bytex64/game-middle-aged-man/logo.dxf

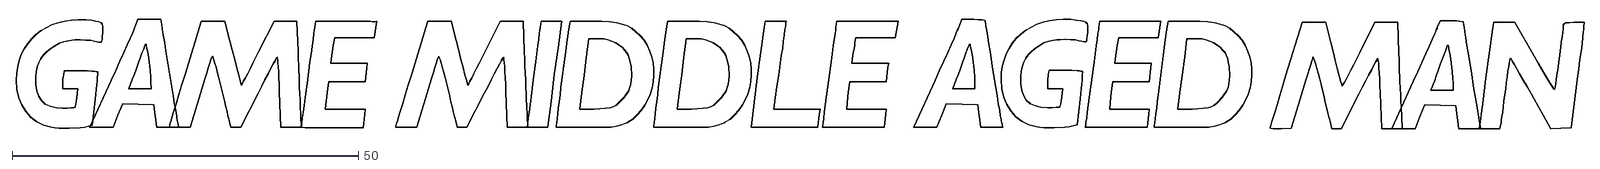
[picture p1: CAD file, 2020-11-22]
logo.dxf
226.6 x 16.3
