bytex64/game-middle-aged-man/gamething.kicad_pcb

## KiCad design gamething.kicad_pcb (2020-11-22)

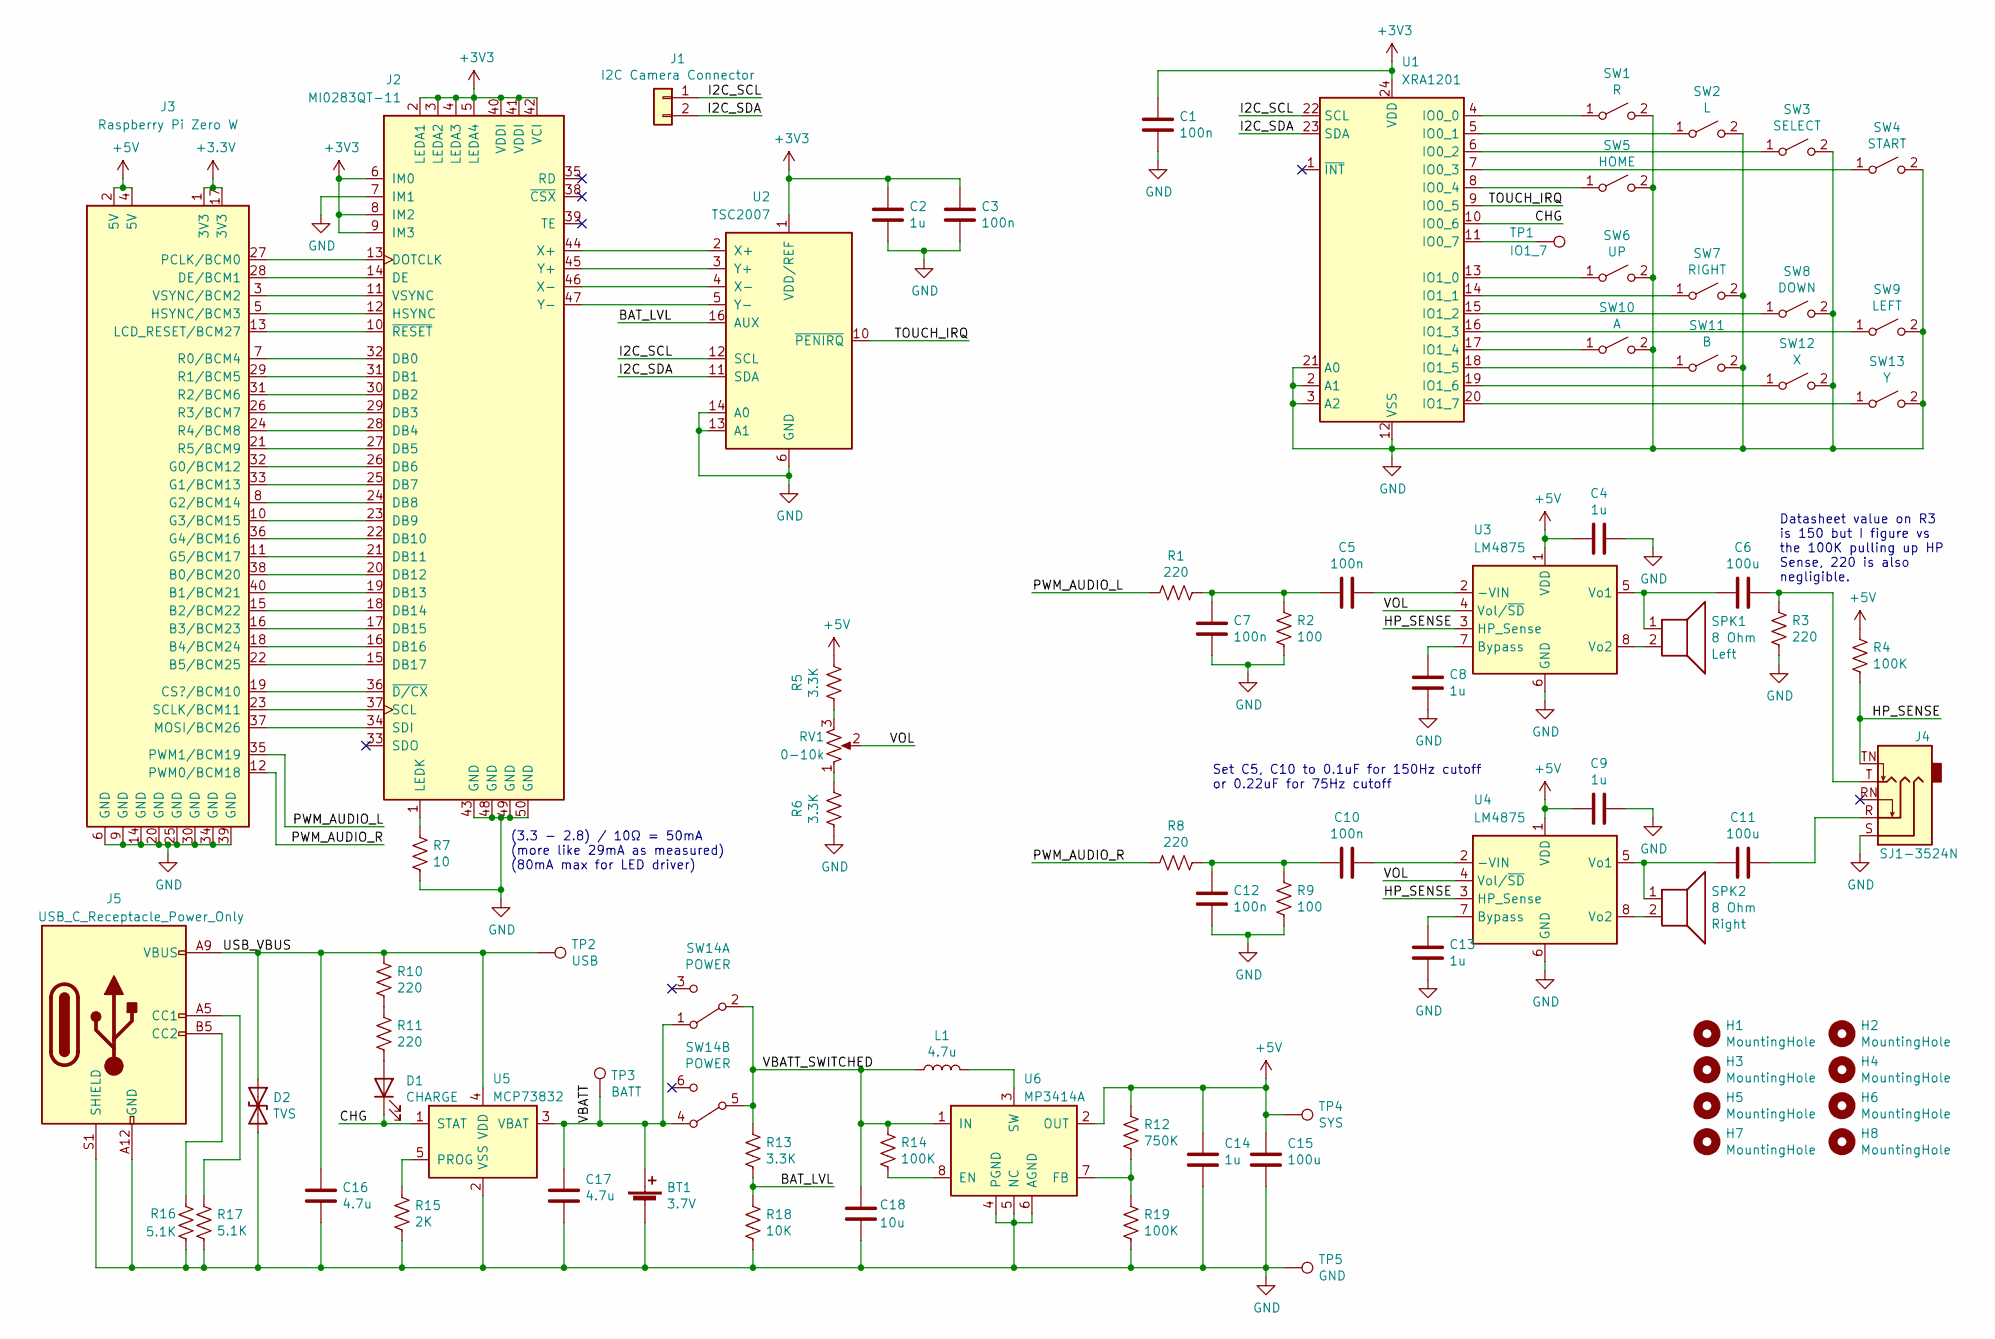
[picture p2: schematic gamething.sch, Game Middle Aged Man]

Parts:
BT1: 3.7V; JST_PH_S2B-PH-K_1x02_P2.00mm_Horizontal; MPN Harwin M22-2210246 or TE 440055-2
C1, C3, C5, C7, C10, C12: 100n; C_0805_2012Metric_Pad1.15x1.40mm_HandSolder; MPN CL21B104KACNNNC
C2, C4, C8, C9, C13, C14: 1u; C_0805_2012Metric_Pad1.15x1.40mm_HandSolder; MPN C0805C105K4RACTU
C6, C11, C15: 100u; C_1206_3216Metric_Pad1.42x1.75mm_HandSolder; MPN JMK316ABJ107ML-T
C16, C17: 4.7u; C_0805_2012Metric_Pad1.15x1.40mm_HandSolder; MPN CL21A475KPFNNNE
C18: 10u; C_0805_2012Metric_Pad1.15x1.40mm_HandSolder; MPN C0805C106K8PACTU
D1: CHARGE; LED_D3.0mm; MPN LTL-4221N
D2: TVS; D_SOD-323_HandSoldering; MPN DF2B7AFU,H3F
H1, H2, H3, H4, H5, H6, H7, H8: MountingHole; MountingHole_2.7mm_M2.5
J1: I2C Camera Connector; PinHeader_1x02_P2.54mm_Vertical
J2: MI0283QT-11; MI0283QT-11_tucked_connector; MPN 62684-50210E9ALF
J3: Raspberry Pi Zero W; Raspberry_Pi_Zero_Socketed_THT_FaceDown_MountingHoles
J4: SJ1-3524N; SJ1-3525N; MPN SJ1-3524N
J5: USB_C_Receptacle_Power_Only; UJC-HP-3-SMT; MPN UJC-HP-3-SMT
L1: 4.7u; L_6x6_H4.5_Handsoldering; MPN TYS60454R7M-10
R1, R3, R8, R10, R11: 220; R_0805_2012Metric_Pad1.15x1.40mm_HandSolder; MPN RK73B2ATTD221J
R2, R9: 100; R_0805_2012Metric_Pad1.15x1.40mm_HandSolder; MPN RK73H2ATTE1000F
R4, R14, R19: 100K; R_0805_2012Metric_Pad1.15x1.40mm_HandSolder; MPN CR0805AFX-1003ELF
R5, R6, R13: 3.3K; R_0805_2012Metric_Pad1.15x1.40mm_HandSolder; MPN CR0805-FX-3301ELF
R7: 10; R_Axial_DIN0207_L6.3mm_D2.5mm_P7.62mm_Horizontal
R12: 750K; R_0805_2012Metric_Pad1.15x1.40mm_HandSolder
R15: 2K; R_0805_2012Metric_Pad1.15x1.40mm_HandSolder; MPN CR0805-FX-2001ELF
R16, R17: 5.1K; R_0805_2012Metric_Pad1.15x1.40mm_HandSolder; MPN RK73B2ATTD512J
R18: 10K; R_0805_2012Metric_Pad1.15x1.40mm_HandSolder; MPN RK73H2ATTD1002F
RV1: 0-10k; RK10J11E; MPN RK10J11E0034
SPK1, SPK2: 8 Ohm; PinHeader_1x02_P2.54mm_Vertical; MPN SM300408-4
SW1: R; B3F-3100; MPN B3F-3100
SW2: L; B3F-3100; MPN B3F-3100
SW3: SELECT; B3F-1000_2terminal; MPN B3F-1000
SW4: START; B3F-1000_2terminal; MPN B3F-1000
SW5: HOME; B3F-1000_2terminal; MPN B3F-1000
SW6: UP; B3F-1000_2terminal; MPN B3F-1000
SW7: RIGHT; B3F-1000_2terminal; MPN B3F-1000
SW8: DOWN; B3F-1000_2terminal; MPN B3F-1000
SW9: LEFT; B3F-1000_2terminal; MPN B3F-1000
SW10: A; B3F-1000_2terminal; MPN B3F-1000
SW11: B; B3F-1000_2terminal; MPN B3F-1000
SW12: X; B3F-1000_2terminal; MPN B3F-1000
SW13: Y; B3F-1000_2terminal; MPN B3F-1000
SW14: POWER; JS202011AQN; MPN JS202011AQN
TP1: IO1_7; TestPoint_THTPad_D1.5mm_Drill0.9mm
TP2: USB; TestPoint_THTPad_D1.5mm_Drill0.9mm
TP3: BATT; TestPoint_THTPad_D1.5mm_Drill0.9mm
TP4: SYS; TestPoint_THTPad_D1.5mm_Drill0.9mm
TP5: GND; TestPoint_THTPad_D1.5mm_Drill0.9mm
U1: XRA1201; TSSOP-24_4.4x7.8mm_P0.65mm; MPN XRA1201PIG24TR-F
U2: TSC2007; TSSOP-16_4.4x5mm_P0.65mm; MPN TSC2007IPWR
U3, U4: LM4875; SOIC-8_3.9x4.9mm_P1.27mm; MPN LM4875MX/NOPB
U5: MCP73832; SOT-23-5; MPN MCP73832T-2ACI/OT
U6: MP3414A; TSOT-23-8; MPN MP3414AGJ-Z

Connections:
+5V: C4.2, C9.2, C14.1, C15.1, J3.2 (5V), J3.4 (5V), R4.2, R5.1, R12.1, TP4.1, U3.1 (VDD), U4.1 (VDD), U6.2 (OUT)
/BAT_LVL: R13.2, R18.1, U2.16 (AUX)
/CHG: D1.1 (K), U1.10 (IO0_6), U5.1 (STAT)
/HP_SENSE: J4.TN, R4.1, U3.3 (HP_Sense), U4.3 (HP_Sense)
/I2C_SCL: J1.1, U1.22 (SCL), U2.12 (SCL)
/I2C_SDA: J1.2, U1.23 (SDA), U2.11 (SDA)
/PWM_AUDIO_L: J3.35 (PWM1/BCM19), R1.2
/PWM_AUDIO_R: J3.12 (PWM0/BCM18), R8.2
/TOUCH_IRQ: U1.9 (IO0_5), U2.10 (~PENIRQ)
/USB_VBUS: C16.1, D2.1 (A1), J5.A9 (VBUS), J5.B9 (VBUS), R10.1, TP2.1, U5.4 (VDD)
/VBATT: BT1.1 (+), C17.1, SW14.1 (A), SW14.4 (A), TP3.1, U5.3 (VBAT)
/VBATT_SWITCHED: C18.1, L1.1, R13.1, R14.1, SW14.2 (B), SW14.5 (B), U6.1 (IN)
/VOL: RV1.2, U3.4 (Vol/~SD), U4.4 (Vol/~SD)
GND: BT1.2 (-), C1.2, C2.2, C3.2, C4.1, C7.2, C8.2, C9.1, C12.2, C13.2, C14.2, C15.2, C16.2, C17.2, C18.2, D2.2 (A2), J2.7 (IM1), J2.43 (GND), J2.48 (GND), J2.49 (GND), J2.50 (GND), J3.6 (GND), J3.9 (GND), J3.14 (GND), J3.20 (GND), J3.25 (GND), J3.30 (GND), J3.34 (GND), J3.39 (GND), J4.S, J5.A12 (GND), J5.B12 (GND), J5.S1 (SHIELD), R2.1, R3.1, R6.2, R7.2, R9.1, R15.2, R16.2, R17.2, R18.2, R19.2, SW1.2 (B), SW2.2 (B), SW3.2 (B), SW4.2 (B), SW5.2 (B), SW6.2 (B), SW7.2 (B), SW8.2 (B), SW9.2 (B), SW10.2 (B), SW11.2 (B), SW12.2 (B), SW13.2 (B), TP5.1, U1.2 (A1), U1.3 (A2), U1.12 (VSS), U1.21 (A0), U2.6 (GND), U2.13 (A1), U2.14 (A0), U3.6 (GND), U4.6 (GND), U5.2 (VSS), U6.4 (PGND), U6.5 (NC), U6.6 (AGND)
unnamed: C5.1, U3.2 (-VIN)
unnamed: C5.2, C7.1, R1.1, R2.2
unnamed: C6.1, J4.T, R3.2
unnamed: C6.2, SPK1.1, U3.5 (Vo1)
unnamed: C8.1, U3.7 (Bypass)
unnamed: C10.1, U4.2 (-VIN)
unnamed: C10.2, C12.1, R8.1, R9.2
unnamed: C11.1, J4.R
unnamed: C11.2, SPK2.1, U4.5 (Vo1)
unnamed: C13.1, U4.7 (Bypass)
unnamed: D1.2 (A), R11.2
unnamed: J2.1 (LEDK), R7.1
unnamed: J2.10 (~RESET), J3.13 (LCD_RESET/BCM27)
unnamed: J2.11 (VSYNC), J3.3 (VSYNC/BCM2)
unnamed: J2.12 (HSYNC), J3.5 (HSYNC/BCM3)
unnamed: J2.13 (DOTCLK), J3.27 (PCLK/BCM0)
unnamed: J2.14 (DE), J3.28 (DE/BCM1)
unnamed: J2.15 (DB17), J3.22 (B5/BCM25)
unnamed: J2.16 (DB16), J3.18 (B4/BCM24)
unnamed: J2.17 (DB15), J3.16 (B3/BCM23)
unnamed: J2.18 (DB14), J3.15 (B2/BCM22)
unnamed: J2.19 (DB13), J3.40 (B1/BCM21)
unnamed: J2.20 (DB12), J3.38 (B0/BCM20)
unnamed: J2.21 (DB11), J3.11 (G5/BCM17)
unnamed: J2.22 (DB10), J3.36 (G4/BCM16)
unnamed: J2.23 (DB9), J3.10 (G3/BCM15)
unnamed: J2.24 (DB8), J3.8 (G2/BCM14)
unnamed: J2.25 (DB7), J3.33 (G1/BCM13)
unnamed: J2.26 (DB6), J3.32 (G0/BCM12)
unnamed: J2.27 (DB5), J3.21 (R5/BCM9)
unnamed: J2.28 (DB4), J3.24 (R4/BCM8)
unnamed: J2.29 (DB3), J3.26 (R3/BCM7)
unnamed: J2.30 (DB2), J3.31 (R2/BCM6)
unnamed: J2.31 (DB1), J3.29 (R1/BCM5)
unnamed: J2.32 (DB0), J3.7 (R0/BCM4)
unnamed: J2.34 (SDI), J3.37 (MOSI/BCM26)
unnamed: J2.36 (~D/CX), J3.19 (CS?/BCM10)
unnamed: J2.37 (SCL), J3.23 (SCLK/BCM11)
unnamed: J2.44 (X+), U2.2 (X+)
unnamed: J2.45 (Y+), U2.3 (Y+)
unnamed: J2.46 (X-), U2.4 (X-)
unnamed: J2.47 (Y-), U2.5 (Y-)
unnamed: J5.A5 (CC1), R17.1
unnamed: J5.B5 (CC2), R16.1
unnamed: L1.2, U6.3 (SW)
unnamed: R5.2, RV1.3
unnamed: R6.1, RV1.1
unnamed: R10.2, R11.1
unnamed: R12.2, R19.1, U6.7 (FB)
unnamed: R14.2, U6.8 (EN)
unnamed: R15.1, U5.5 (PROG)
unnamed: SPK1.2, U3.8 (Vo2)
unnamed: SPK2.2, U4.8 (Vo2)
unnamed: SW1.1 (A), U1.4 (IO0_0)
unnamed: SW2.1 (A), U1.5 (IO0_1)
unnamed: SW3.1 (A), U1.6 (IO0_2)
unnamed: SW4.1 (A), U1.7 (IO0_3)
unnamed: SW5.1 (A), U1.8 (IO0_4)
unnamed: SW6.1 (A), U1.13 (IO1_0)
unnamed: SW7.1 (A), U1.14 (IO1_1)
unnamed: SW8.1 (A), U1.15 (IO1_2)
unnamed: SW9.1 (A), U1.16 (IO1_3)
unnamed: SW10.1 (A), U1.17 (IO1_4)
unnamed: SW11.1 (A), U1.18 (IO1_5)
unnamed: SW12.1 (A), U1.19 (IO1_6)
unnamed: SW13.1 (A), U1.20 (IO1_7)
unnamed: TP1.1, U1.11 (IO0_7)

Notes on the sheet:
(3.3 - 2.8) / 10Ω = 50mA (more like 29mA as measured) (80mA max for LED driver)
Set C5, C10 to 0.1uF for 150Hz cutoff or 0.22uF for 75Hz cutoff
Datasheet value on R3 is 150 but I figure vs the 100K pulling up HP Sense, 220 is also negligible.

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
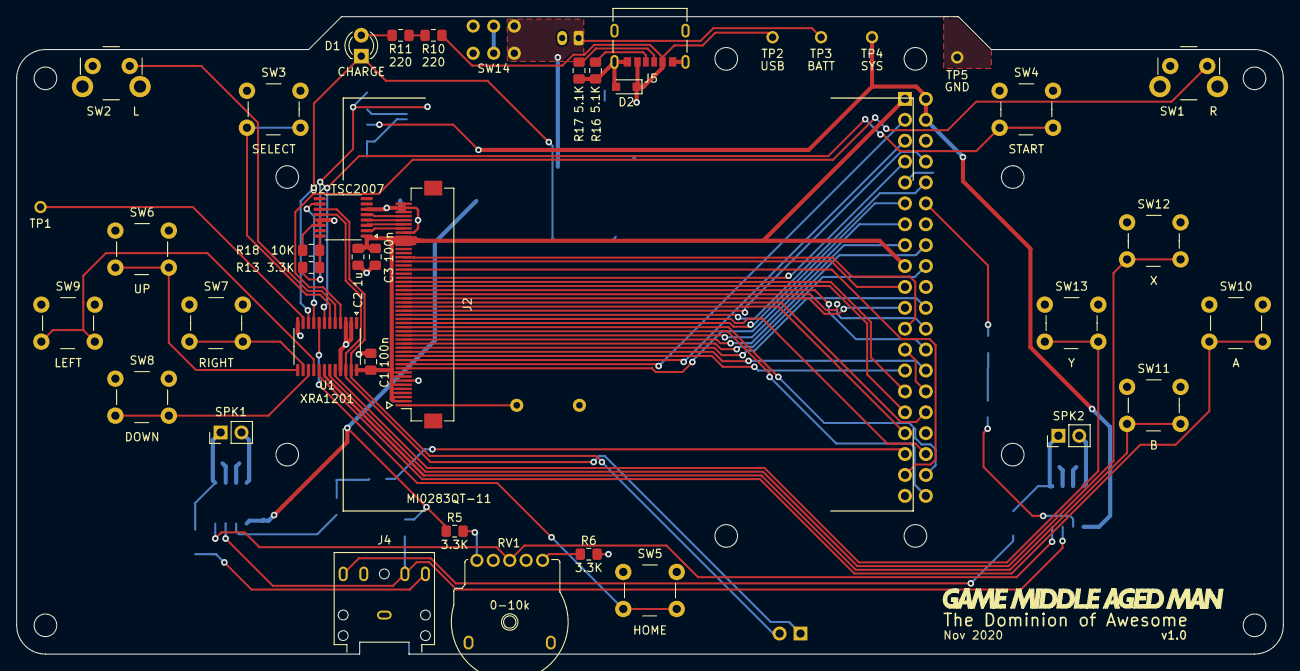
[picture p3: board gamething.kicad_pcb from above]

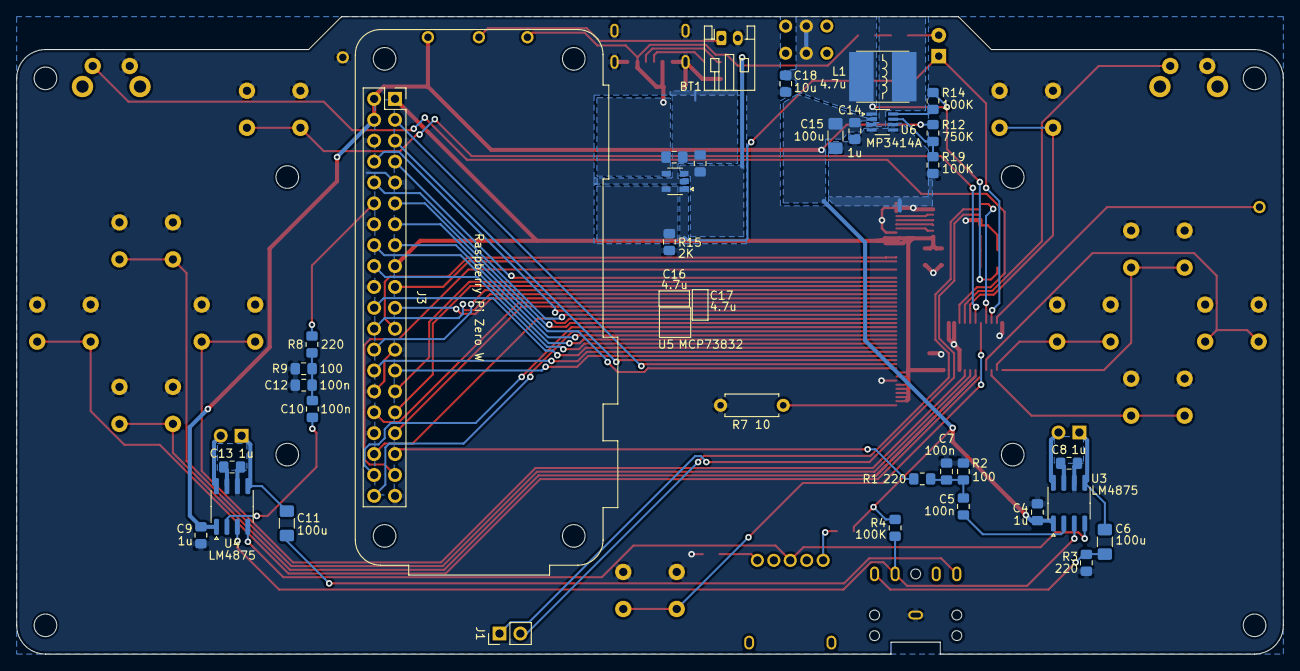
[picture p4: board gamething.kicad_pcb from below]

Board: 2 copper layers, 154.0 x 77.5 mm, 82 parts (34 on the bottom side), 82 nets.
