bytex64/game-middle-aged-man/(commit log)

2020-11-22 Add logo to board
    [gamething.kicad_pcb, logo.dxf]
2020-11-22 Post-release updates
    [gamething.kicad_pcb]
